fruenger/weather_station/code/weather_station_r4_wifi/README.md

# Weather Station — Arduino UNO R4 WiFi

Standard setup of the station: **one board** reads all sensors and uploads directly to the OST Django API over WiFi. It replaces the former two-board nRF24 setup (archived in `../../legacy/nrf24/`); no receiver Arduino and no `receive.py` on a PC.

## Architecture

```
[Sensors + PCA9548] ──I2C/GPIO──► [UNO R4 WiFi] ──HTTPS──► [Django API / Website]
```

Compared to the former nRF24 setup (`legacy/nrf24/`):

| nRF24 setup | R4 WiFi |
|---|---|
| Sender Arduino + nRF24 | **not needed** |
| Receiver Arduino + nRF24 | **not needed** |
| PC running `receive.py` | **not needed** |
| USB cable for data path | **not needed** |

## Hardware

### Board

- **Arduino UNO R4 WiFi** (not the UNO R4 Minima — Minima has no WiFi)
- Power: 6–24 V on `VIN` (solar/battery) or USB for bench testing
- **2.4 GHz WiFi** only (no 5 GHz)

### Sensors (unchanged)

Same sensors and channel assignment as the former nRF24 sender; pin mapping is identical to `legacy/nrf24/weather_station/weather_station.ino`. The multiplexer is an Adafruit PCA9548 STEMMA QT board (TCA9548A compatible, same address 0x70, no firmware change) on the header I2C bus with V+ = 5 V and its Vlogic switch on 3.3 V, so it also supplies the I2C sensors with 3.3 V. Exception: the PMSA003I takes VIN from the 5 V rail (its fan current would overheat the multiplexer's 3.3 V regulator); only GND/SDA/SCL come from port 0, never connect the red STEMMA QT wire. Do not use the R4's Qwiic port for it: that is a separate 3.3 V-only bus (`Wire1`).

| Pin | Function |
|-----|---|
| A4 (SDA), A5 (SCL) | I2C → PCA9548 (header bus `Wire`, 5 V logic) |
| D2 | Rain reed (tipping bucket) |
| D3 | Anemometer reed contact (interrupt), external RC debounce: R1 10 kΩ to 5 V, C1 100 nF to GND, R2 1 kΩ to the contact |
| D4 | → RESET pin: periodic self-reset, off by default since v1.9.1 (`AUTO_RESET_ENABLED`); input during operation, output LOW to reset |
| D5 | Rain drop digital |
| D6 | PMSA003I SET (sleep/wake) |
| A1 | Rain drop analog |

**Removed:** D8–D12 (formerly nRF24L01 SPI) — no wiring needed.

See `../../wiring/pin_connections_r4_wifi.txt` for the full pin table.

### Power notes (solar / battery)

- R4 WiFi draws more current than a Nano, especially during WiFi transmit.
- Keep **PMSA003I sleep/wake** (already in firmware).
- **WiFi stays connected** (since v1.8). Switching it off between uploads and re-joining every minute was the main cause of hangs in v1.7; the idle connection costs a few tens of mA more.
- Use a solid 5 V regulator and local capacitors on the board and sensors.
- `SERIAL_DEBUG` must be `0` in the field (no USB Serial reader).

## Upload strategy (v1.9 — cooperative scheduler, bulk upload)

| Setting | Value | Meaning |
|---|---|---|
| Snapshot | **1 Hz** (1 s) | Ring buffer + wind pulse window |
| BME280 | **1 Hz** | Temperature, humidity, pressure |
| TSL2591 | **1 Hz** | Lux, non-blocking poll with auto-ranging (see below) |
| MLX90614 | **0.5 Hz** | Sky / box IR temperature |
| UV | **1 Hz** | UV index |
| Rain | **2 Hz** | Reed tips + drop sensor |
| PM | **5 min** | Sleep/wake cycle (unchanged) |
| Ring buffer | **180 samples** | 3 min at 1 Hz |
| Startup live | **5 min @ 1 Hz** | One request per sample, for commissioning |
| Burst | **every 60 s** | Bulk request(s) of ≤ 120 samples (CSV), one TLS session, max 45 s |
| Watchdog | **120 s** | Reset if the main loop stops checking in |
| Upload stall reset | **10 min** | Reset if nothing could be uploaded for 10 min |

### Bulk upload and I2C recovery (v1.9)

v1.8 still stopped uploading about 30 s after the end of the startup live mode. The cause was the I2C bus: it got stuck right after the first PMSA003I measurement (multiplexer channel 0 stayed selected while the sensor was put to sleep). Every I2C access then waited 100 ms for its timeout, the sensors returned garbage (BME280 180 °C, UV 65535), and the first invalid sample in the ring buffer blocked all further uploads. v1.9 changes:

- **Bulk upload:** after the live mode all samples of a minute are sent in one request to `<api path>bulk/` (`Content-Type: text/csv`, header line + one row per sample, see `bulk_csv.h` and the website `docs/upload-hmac-v1.md`). The body is formatted twice — once to compute length and SHA-256 for the signature, once to send it in ~512 byte pieces — so it is never held in RAM as a whole. The server skips invalid rows and samples it already stored, so a retry after a lost response creates no duplicates. **The website must support the bulk endpoint before v1.9 is flashed.**
- **1 Hz snapshots:** wind and rain are counted per second; the website's wind conversion (× 0.14 per revolution per second) now matches directly.
- **No head-of-line blocking:** invalid samples are not sent (counted as `discarded` in the debug report); a block the server rejects with HTTP 400 is dropped instead of retried forever.
- **I2C robustness:**
  - All multiplexer channels are switched off after every PMSA003I access, before the sensor is put to sleep.
  - Readings are checked: an implausible BME280 reading marks the sample as not uploadable, MLX90614 failures are sent as 0/0 ("not available"), UV failures as 0.
  - After `SENSOR_FAIL_LIMIT` failures in a row a sensor is re-initialised.
  - If the multiplexer stops answering or several sensors fail at once, the bus is recovered: 9 SCL pulses, a STOP, `Wire.begin()`, then all sensors are re-initialised. The interval between recoveries grows while they do not help.
- **Upload stall reset:** if nothing could be uploaded for 10 min, the board resets (last resort for failures that leave the loop running).

### Reliable uploads (v1.8)

Firmware up to v1.7 hung a few minutes after boot, as soon as it switched from startup live mode to burst mode. v1.8 changes:

- **Fast responses:** the reply is read up to its `Content-Length` and the connection is reused at once. Before, the firmware waited up to 2 s per upload for the server to close a keep-alive connection, so a burst of 120 samples took several minutes.
- **WiFi stays connected**; it is only re-joined after a failure. `WiFi.begin()` waits at most `WIFI_BEGIN_TIMEOUT_MS`, the rest of `WIFI_CONNECT_TIMEOUT_MS` is polled by the sketch.
- **NTP only every 20 min** (`NTP_RESYNC_INTERVAL_MS`), no longer up to three times per burst.
- **Failed bursts are retried once per `UPLOAD_BURST_INTERVAL_MS`**, not on every snapshot (which blocked the loop with back-to-back connection attempts). Live mode pauses `LIVE_RETRY_DELAY_MS` after a failure.
- **Measuring continues during a burst** (2 Hz snapshots are appended to the ring buffer between uploads); a burst returns to the main loop after `BURST_MAX_DURATION_MS` at the latest.
- **Software watchdog:** a 50 Hz timer interrupt resets the board when the main loop has not checked in for `WATCHDOG_TIMEOUT_MS` (120 s), e.g. inside a hanging library call. The RA4M1 hardware watchdog cannot be used: its maximum of ~5.6 s is shorter than single WiFi modem commands (up to 10 s).
- **Timestamps with millisecond resolution** (`jd` with 7 decimals, ~9 ms). Before, `jd` had 5 decimals (0.86 s) and whole seconds, so samples taken 0.5 s apart could share a timestamp.

### Slower sensors between snapshots

Values for sensors polled less often than the snapshot interval are **held** (last known reading), not averaged. Example: MLX90614 updates every 2 s; the snapshot in between repeats the previous sky/box temperature. This keeps each buffer row self-contained without inventing synthetic averages.

### Light sensor (TSL2591, since v1.6; lux formula since v1.7)

The driver (`TSL2591.cpp`, logic in `tsl2591_logic.h`) integrates continuously and is polled without blocking: `TSL2591_Poll()` returns immediately when no integration has finished, so the 2 Hz snapshot and rain polling are not delayed (the old driver blocked for ≥ 300 ms per read).

- **Auto-ranging in both directions** over eight gain × integration-time stages, from 1×/100 ms (direct sun) to 9876×/600 ms (night sky). A channel at ≥ 90 % of full scale steps one stage down, a reading that would stay below 50 % of full scale on the next stage steps one up. Readings in a saturated state are discarded, except on the least sensitive stage, where they are reported as a lower bound.
- **Lux as float** with the formula of the Adafruit TSL2591 library (since v1.7): `(ch0 − ch1)·(1 − ch1/ch0) / (t·gain / 408)`, capped at 200 000 lx. Unlike the Waveshare formula `(ch0 − 2·ch1) / (t·gain / 762)` used up to v1.6, it stays positive for infrared-rich light (street lighting, light-polluted night sky), so the night sky brightness is measured instead of reading 0 (older drivers wrapped those cases to values such as 53 000 lx).
- **Scale change in v1.7:** values are not comparable with earlier firmware. Daylight (infrared fraction `ch1/ch0` ≈ 0.15–0.3) reads about 40 % lower than with v1.6; at `ch1/ch0` ≥ 0.5 v1.6 reported 0. When flashing v1.7, add a **Calibration epoch** in the website admin so the cloud detection recalibrates.
- In direct sun even the least sensitive stage (1×/100 ms) can saturate. Only `ch0` clips, so the reported value is a lower bound well below the true illuminance; it still marks the interval as very bright.
- **I2C errors** (no ACK, short read) keep the last valid value; after 60 consecutive errors the sensor is re-initialised. `TSL2591_Init()` checks the chip ID, so a missing sensor is reported as unavailable.
- The upload sends `illuminance` with three decimals to resolve the night sky brightness.

Host test of the logic: `cd tools && g++ -std=c++17 -Wall -Wextra -o tsl2591_selftest tsl2591_selftest.cpp && ./tsl2591_selftest`

### Wind

Firmware uploads **raw revolutions per second** (1 Hz snapshots, since v1.9). Rolling means and gust detection belong on the server — see `TODO.md`.

**Buffer sizing:** `RING_BUFFER_SIZE` must be ≥ `UPLOAD_BURST_INTERVAL_MS / SNAPSHOT_INTERVAL_MS` + spare. At 60 s / 1 s → 60 samples; buffer = 180 (one missed burst plus margin).

## Software setup

### 1. Arduino IDE

1. Install board package: **Arduino UNO R4 Boards** (Boards Manager).
2. Select board: **Arduino UNO R4 WiFi**.
3. **Tools → Firmware Updater** — update the WiFi module firmware once (required for HTTPS).

### 2. Libraries

Same as the former nRF24 sender:

- Adafruit BME280, MLX90614, PM25 AQI, BusIO, Unified Sensor
- DFRobot UVIndex240370Sensor + DFRobot RTU
- TSL2591 support files are included in this folder (`DEV_Config.*`, `TSL2591.*`)

No RF24 library needed.

### 3. Credentials (WEATHER-HMAC-V1)

```bash
cd weather_station/code/weather_station_r4_wifi
cp secrets.h.example secrets.h
# Edit secrets.h — WiFi + device_id / key_id / HMAC secret
```

Provision the device on the Django server (from the website project):

```bash
python manage.py provision_upload_device --device-id <your-device-id> --key-id key1
```

Copy the printed `device_id`, `key_id`, and 64-char hex `secret` into `secrets.h` as `SECRET_DEVICE_ID`, `SECRET_KEY_ID`, and `SECRET_HMAC_SECRET_HEX`.

| Define | Purpose |
|---|---|
| `SECRET_WIFI_SSID` / `SECRET_WIFI_PASS` | Observatory 2.4 GHz WiFi |
| `SECRET_API_HOST` / `SECRET_API_PATH` | HTTPS POST target |
| `SECRET_HMAC_PATH` | Canonical signing path (default: `/weather_station/weather_api/datasets/`) |
| `SECRET_DEVICE_ID` | Provisioned device id |
| `SECRET_KEY_ID` | Active signing key id |
| `SECRET_HMAC_SECRET_HEX` | 32-byte secret as 64 hex chars |

**Never log or commit** `SECRET_HMAC_SECRET_HEX` or signatures in the field. Use `SERIAL_DEBUG` only on the bench.

`SECRET_HMAC_PATH` is used only for the canonical string. `SECRET_API_PATH` may differ for local testing, but production should keep both equal.

### 4. Upload sketch

Open `weather_station_r4_wifi.ino` in the Arduino IDE and upload.

For first tests, set `#define SERIAL_DEBUG 1` in the sketch, open Serial Monitor at **115200 baud** (`SERIAL_BAUD`), and verify:

- All sensors initialize
- `weatherHmacSelfTest OK` (known test vectors)
- `NTP time synced` before any upload
- `Upload mode: startup live (1 Hz)` then uploads each second
- After 5 min: `Upload mode: burst (buffered)` and `Burst upload: N samples`

At boot (debug only) an **I2C scan** lists the devices on the main bus and on every multiplexer channel, and marks missing expected sensors:

```
I2C scan
  main bus: 0x70 (multiplexer)
  channel 0: -   <-- expected 0x12 (PMSA003I), answers only while awake
  channel 1: 0x76 (BME280)
  channel 2: 0x23 (SEN0636)
  channel 3: 0x5A (MLX90614)
  channel 4: -   <-- expected 0x29 (TSL2591)
  channel 5: -
  ...
```

Nothing on a channel means no power or no I2C connection on that port (check wire order: black GND, red 3.3 V, blue SDA, yellow SCL); a device at an unexpected address points to a different module or address jumper. Sensors not found at boot are searched again every `SENSOR_RETRY_INTERVAL_MS` (60 s), so a sensor plugged in or repaired later is picked up without a reset.

Every `DEBUG_INTERVAL_MS` (2 s) a sensor report shows the current reading of each sensor (`not available` if it was not found at boot):

```
--- t=125 s [live]  buffer 0/130  pkt 118  uploads ok/failed 118/0
BME280    T 21.34 C   RH 45.2 %   p 1013.2 hPa
MLX90614  sky 18.20 C   box 22.10 C   sky-box -3.90 K   sky-air -3.14 K
TSL2591   1234.567 lx   ch0 2861  ch1 512   stage 3 (25x 400 ms)
SEN0636   UV index 1   raw 412
PMSA003I  PM1.0 3  PM2.5 5  PM10 6 ug/m3   asleep, next in 212 s
Rain      tips 2 since boot   D2 HIGH   drop sensor dry (D5 HIGH, A1 1015)
Wind      pulses 6 per s   6.0 /s (last 2.0 s)   total 412   D3 HIGH
```

Hardware checks with the report:

- **TSL2591:** cover the sensor and shine a lamp on it; the stage should step up in the dark and down in bright light, `ch0` should stay below ~90 % of full scale (36863 at 100 ms, 65535 otherwise) except in direct sun on stage 0.
- **SEN0636:** `raw` resolves much finer than the integer UV index, useful to compare windows (plexiglass vs. quartz).
- **Rain gauge:** tip the bucket slowly by hand and count; `tips` should increase by exactly one per tip. The firmware counts every change of D2, so a reed that only closes briefly while the bucket passes would count two per tip.
- **Anemometer:** turn the cups slowly by hand, one revolution at a time; the pulse total should increase by the number of contact closures per revolution, not by more (otherwise check the RC debounce on D3).
- **Rain drop sensor:** a wet finger on the plate switches it to `wet` and lowers `A1`.

For deployment, set `SERIAL_DEBUG 0` and re-flash.

## API upload format

The sketch POSTs `application/x-www-form-urlencoded` data to:

`https://<SECRET_API_HOST><SECRET_API_PATH>`

### WEATHER-HMAC-V1 authentication

Each POST is signed over the **exact raw body bytes** sent on the wire. Headers:

| Header | Value |
|---|---|
| `X-Weather-Device` | `SECRET_DEVICE_ID` |
| `X-Weather-Key-Id` | `SECRET_KEY_ID` |
| `X-Weather-Timestamp` | Unix UTC seconds (requires NTP) |
| `X-Weather-Nonce` | 32 lowercase hex chars (16 random bytes from hardware TRNG) |
| `X-Weather-Signature` | lowercase hex HMAC-SHA256 |

Canonical string (UTF-8, no trailing newline), lines joined by `\n`:

```
WEATHER-HMAC-V1
POST
<SECRET_HMAC_PATH>
application/x-www-form-urlencoded
<device_id>
<key_id>
<timestamp>
<nonce>
<sha256_hex_of_exact_raw_body>
```

Signing uses vendored **SHA-256 / HMAC-SHA256** (`sha256.c`, based on Brad Conte's public-domain crypto-algorithms). Nonces come from the Renesas **SCE hardware TRNG** (`HW_SCE_RNG_Read`, same path as the ArduinoCore `WMath` TRNG). No mbedtls Library Manager package and no `random()` fallback — if TRNG or signing fails, the upload is skipped and samples stay buffered.

NTP is refreshed about every **20 minutes**. Uploads require `timeSynced`.

On HTTP **401**, **403**, or **429**, buffered samples are **not** dropped. The firmware parses `Retry-After` when present and applies exponential backoff (60 s initial, up to 30 min).

### Payload fields

`jd`, `temperature` (°C), `pressure` (hPa), `humidity` (%), `illuminance` (lux), `wind_speed` (revolutions per sample), `rain` (mm collector depth), `sky_temp`, `box_temp`, `is_raining`, `pm1_0`, `pm2_5`, `pm10`, `uv_index`

Unit conversions applied in firmware:

- **Rain:** tipping-bucket count × 1.25 → mm collector depth (same as the former `receive.py`)
- **Wind:** raw anemometer revolutions per 1 s snapshot, capped at 500 (server converts × 0.14 → m/s)

## Configuration (in .ino)

| Constant | Default | Purpose |
|---|---|---|
| `SERIAL_DEBUG` | `0` | USB debug output |
| `SNAPSHOT_INTERVAL_MS` | `1000` | Ring buffer / wind window (1 Hz) |
| `INTERVAL_BME_MS` | `1000` | BME280 poll rate |
| `INTERVAL_LUX_MS` | `1000` | TSL2591 poll rate |
| `INTERVAL_MLX_MS` | `2000` | MLX90614 poll rate |
| `INTERVAL_UV_MS` | `1000` | UV sensor poll rate |
| `INTERVAL_RAIN_MS` | `500` | Rain reed + drop poll rate |
| `LIVE_UPLOAD_INTERVAL_MS` | `1000` | Startup live upload rate (1 Hz) |
| `STARTUP_LIVE_UPLOAD_MS` | `300000` | Live upload period after boot (5 min) |
| `UPLOAD_BURST_INTERVAL_MS` | `60000` | Burst upload interval in field mode |
| `RING_BUFFER_SIZE` | `180` | Max buffered samples (3 min @ 1 Hz) |
| `BULK_MAX_ROWS` | `120` | Samples per bulk request |
| `WIFI_CONNECT_TIMEOUT_MS` | `20000` | WiFi join timeout |
| `WIFI_BEGIN_TIMEOUT_MS` | `4000` | Time `WiFi.begin()` blocks before the sketch polls |
| `BURST_MAX_DURATION_MS` | `45000` | Max duration of one burst |
| `LIVE_RETRY_DELAY_MS` | `10000` | Pause after a failed live upload |
| `WATCHDOG_TIMEOUT_MS` | `120000` | Software watchdog: reset after 2 min without loop progress |
| `UPLOAD_STALL_RESET_MS` | `600000` | Reset after 10 min without a successful upload |
| `AUTO_RESET_ENABLED` | `0` | Periodic self-reset every `RESET_INTERVAL` (1 h) through D4 → RESET |
| `SENSOR_FAIL_LIMIT` | `3` | Implausible readings in a row before a sensor is re-initialised |
| `I2C_RECOVERY_MIN_INTERVAL_MS` | `10000` | Minimum time between I2C bus recoveries (doubles up to 5 min) |
| `NTP_RESYNC_INTERVAL_MS` | `1200000` | Re-sync NTP every 20 min |
| `UPLOAD_BACKOFF_INITIAL_MS` | `60000` | Initial auth/rate-limit backoff |
| `UPLOAD_BACKOFF_MAX_MS` | `1800000` | Max backoff (30 min) |
| `PM_MEASUREMENT_INTERVAL` | `300000` | PMSA003I wake every 5 min |
| `DISABLE_LED_MATRIX` | `1` | Blank onboard 12×8 LED matrix |

## Power saving

- **Burst upload:** snapshot 2 Hz, uploads once per minute (WiFi stays associated since v1.8)
- **Cooperative scheduler:** each sensor at its own rate (≤ 2 Hz); short `delay()` until next timer
- **Non-blocking wind:** permanent interrupt, 1 s pulse windows
- **Startup live:** 5 min persistent WiFi for easy commissioning, then auto switch to burst
- **`DISABLE_LED_MATRIX`**: all onboard LEDs off after boot
- **`SERIAL_DEBUG 0`**: no blocking Serial in the field
- **PMSA003I sleep/wake**: fan/laser off between PM cycles
- **Rain per interval:** tips per 1 s sample window

## Troubleshooting

| Symptom | Check |
|---|---|
| `WiFi module not found` | Firmware updater, board selection (R4 **WiFi**) |
| `SSL connect failed` | WiFi firmware version, host reachable on 443 |
| `WiFi connect failed` | Signal at the station; WiFi is re-joined once per burst interval |
| `Bulk upload failed, HTTP 0` | No response (timeout); retried with the next burst |
| `Bulk upload rejected (HTTP 400)` | Server rejected the request format; the block is dropped — check the website version (bulk endpoint deployed?) |
| `I2C bus recovery` | The multiplexer stopped answering or several sensors failed; sensors are re-initialised |
| `... failed repeatedly, will be re-initialised` | One sensor returned implausible values `SENSOR_FAIL_LIMIT` times |
| `No successful upload for 10 min, resetting` | Upload stall reset; check WiFi, server and the lines before |
| `Burst time limit reached` | Many samples queued (e.g. after an outage); the rest follows |
| `watchdog OFF` in the debug report | No free timer for the software watchdog |
| Station restarts by itself | Software watchdog (loop blocked > 2 min), upload stall reset (10 min), or the periodic reset via D4 if `AUTO_RESET_ENABLED` is 1 |
| `NTP time sync failed` | Internet access from observatory WiFi |
| `Upload skipped: time not synced` | Wait for NTP; uploads buffer until clock is valid |
| `weatherHmacSelfTest failed` | SHA256/HMAC mismatch — re-flash; check `sha256.c` is compiled with the sketch |
| `Upload skipped: HMAC signing failed` | SCE TRNG or secret parse failure; check `SECRET_HMAC_SECRET_HEX` |
| `Upload deferred (backoff)` | Recent 401/403/429; waits per Retry-After / exponential backoff |
| `Upload skipped: validation failed` | Sensor wiring / bogus readings |
| HTTP 401 / 403 | Wrong device id, key id, or secret; re-provision or rotate key |
| HTTP 429 | Rate limited; firmware backs off, buffer retained |
| HTTP 400 | Field out of range — check Serial debug values |

### HTTPS / certificates

The R4 WiFi firmware embeds a CA bundle that works with most public HTTPS sites (including Let's Encrypt). If SSL fails only for your server, update the WiFi firmware or add a custom root CA via `sslClient.setCACert()` (see [Arduino SSL docs](https://docs.arduino.cc/tutorials/uno-r4-wifi/wifi-examples)).

## Migration from the nRF24 setup (done)

Kept for reference; the old sketches and `receive.py` are in `../../legacy/nrf24/`.

1. Move the sensor shield/cabling from the old sender Uno/Nano to the R4 WiFi (same pins).
2. Remove both nRF24 modules.
3. Configure `secrets.h` and flash `weather_station_r4_wifi.ino`.
4. Run in parallel with the old receiver for a few days if desired.
5. Decommission receiver Arduino + `receive.py` when stable.

## HMAC debug / self-test

**Bench only** (`SERIAL_DEBUG 1`):

1. On boot, confirm `weatherHmacSelfTest OK`.
2. Confirm `NTP time synced` before uploads.
3. Log HTTP status lines only — never print `SECRET_HMAC_SECRET_HEX`, nonces, or signatures in production.

**Host-side checks** (Linux, OpenSSL dev headers; run in CI by `.github/workflows/firmware-selftests.yml`):

```bash
cd code/weather_station_r4_wifi/tools
g++ -std=c++17 -Wall -Wextra -o hmac_selftest hmac_selftest.cpp -lcrypto && ./hmac_selftest
gcc -Wall -c ../sha256.c -o sha256.o
g++ -std=c++17 -Wall -Wextra -o bulk_csv_selftest bulk_csv_selftest.cpp sha256.o && ./bulk_csv_selftest
g++ -std=c++17 -Wall -Wextra -o tsl2591_selftest tsl2591_selftest.cpp && ./tsl2591_selftest
```

The binaries are gitignored.

Expected vectors are in `tools/hmac_test_vectors.txt`. Firmware `weatherHmacSelfTest()` uses the same constants.

## File layout

```
weather_station_r4_wifi/
├── weather_station_r4_wifi.ino   # Main sketch
├── weather_hmac.h / .cpp         # WEATHER-HMAC-V1 helpers
├── bulk_csv.h                    # CSV line format of the bulk upload (host-testable)
├── sha256.h / .c                 # Vendored SHA-256 + HMAC (no mbedtls)
├── secrets.h.example             # Template credentials
├── secrets.h                     # Your credentials (gitignored, create locally)
├── tools/
│   ├── hmac_test_vectors.txt     # Known WEATHER-HMAC-V1 digests
│   ├── hmac_selftest.cpp         # Host OpenSSL vector check
│   ├── bulk_csv_selftest.cpp     # Host check of bulk CSV + incremental SHA-256
│   └── tsl2591_selftest.cpp      # Host check of lux formula + auto-ranging
├── TODO.md                       # Open items: energy, wind, light sensor
├── DEV_Config.* / TSL2591.*      # Light sensor driver (I2C helpers, polling)
├── tsl2591_logic.h               # Lux formula + auto-ranging (host-testable)
└── README.md                     # This file
```
