fruenger/weather_station/wiring/wiring_r4_wifi.html

# Weather station wiring

Arduino UNO R4 WiFi with Adafruit PCA9548 I²C multiplexer (TCA9548A compatible). Hover a wire, pin or rail label to highlight its connections; click a component for its pin table. Power is drawn as rail labels: every pin labelled 5V, 3V3 or GND is connected to that rail.

### Select a component

Click a box in the diagram.

The panel lists every pin of the selected component and what it is connected to.

Clear selection

## Signal and I²C connections

Net | From | To | Notes

## Power rails

Rail | Pins | Notes

## Notes

- Power is drawn as net labels: all pins labelled 5V, 3V3 or GND are connected to that rail.
- PCA9548 on the header I²C bus (A4/A5, 5 V logic) with V+ = 5 V; not on the Qwiic port (separate 3.3 V bus Wire1).
- Vlogic switch on 3.3 V: the ports supply the I²C sensors with 3.3 V power and logic (on-board regulator, max 500 mA).
- PMSA003I: VIN from the 5 V rail (fan current would overheat the 3.3 V regulator); do not connect the red STEMMA QT wire.
- Anemometer (reed contact, 2 wires): RC debounce with R1 10 kΩ pull-up to 5 V, C1 100 nF to GND, R2 1 kΩ in series with the contact.
- D4 → RESET for the optional periodic self-reset (off by default since firmware 1.9.1). D8–D12 are free.
- Bulk capacitor on the 5 V rail and 100 nF at every module recommended (PMSA003I fan, WiFi bursts).
