fruenger/weather_station/code/weather_station_r4_wifi/DEV_Config.cpp

/*****************************************************************************
* | File      	:   DEV_Config.c
* | Author      :   Waveshare team
* | Function    :   Hardware underlying interface
* | Info        :
*----------------
* |	This version:   V2.0
* | Date        :   2019-07-08
* | Info        :   Basic version
*
******************************************************************************/
#include "DEV_Config.h"

uint8_t DEV_SPI_Device = 0, DEV_I2C_Device = 0;
uint8_t I2C_ADDR;
/******************************************************************************
function:	GPIO Function initialization and transfer
parameter:
Info:
******************************************************************************/
void DEV_GPIO_Mode( UWORD Pin, UWORD mode)
{
    /*
        0:  INPT   
        1:  OUTP
    */
	if(mode == INPUT || mode == 0){
        pinMode(Pin, INPUT);
	}else if(mode == OUTPUT || mode == 1){
		pinMode(Pin, OUTPUT);
	}
}


/**
 * delay x ms
**/
void DEV_Delay_ms(UDOUBLE xms)
{
	delay(xms);
}


void GPIO_Config(void)
{
    //DEV_GPIO_Mode(INT_PIN, 0);
}

/******************************************************************************
function:	SPI Function initialization and transfer
parameter:
Info:
******************************************************************************/
void DEV_SPI_Init()
{
#if DEV_SPI  
	DEV_SPI_Device = 1;
#endif
}

void DEV_SPI_WriteByte(uint8_t Value)
{
#if DEV_SPI  
	
#endif
}

void DEV_SPI_Write_nByte(uint8_t *pData, uint32_t Len)
{
#if DEV_SPI  
	
#endif
}
/******************************************************************************
function:	I2C Function initialization and transfer
parameter:
Info:
******************************************************************************/
// Wire.begin() is called once by the sketch (initializeI2CMultiplexer)
void DEV_I2C_Init(uint8_t Add)
{
#if DEV_I2C 
    DEV_I2C_Device = 1;
    I2C_ADDR =  Add;
#endif
}

void I2C_Write_Byte(uint8_t Cmd, uint8_t value)
{
#if DEV_I2C 
    Wire.beginTransmission(I2C_ADDR);
    Wire.write(Cmd);
    Wire.write(value & 0xFF);
    Wire.endTransmission();
#endif
}

// Returns the byte, or -1 if the device did not answer
int I2C_Read_Byte(uint8_t Cmd)
{
#if DEV_I2C 
    Wire.beginTransmission(I2C_ADDR);
    Wire.write(Cmd);
    if (Wire.endTransmission() != 0) {
        return -1;
    }
    if (Wire.requestFrom(I2C_ADDR, (size_t)1) != 1 || !Wire.available()) {
        return -1;
    }
    return Wire.read();
#endif
}

// Returns the little-endian word (0..65535), or -1 if the device did not answer
int I2C_Read_Word(uint8_t Cmd)
{
#if DEV_I2C 
    uint16_t x; uint16_t t;

    Wire.beginTransmission(I2C_ADDR);
    Wire.write(Cmd); 
    if (Wire.endTransmission() != 0) {
        return -1;
    }
    if (Wire.requestFrom(I2C_ADDR, (size_t)2) != 2 || Wire.available() < 2) {
        return -1;
    }
    t = Wire.read();
    x = Wire.read();
    x <<= 8;
    x |= t;
    return x;
#endif
}
/******************************************************************************
function:	Module Initialize, the library and initialize the pins, SPI protocol
parameter:
Info:
******************************************************************************/
UBYTE DEV_ModuleInit(void)
{
    GPIO_Config();
    DEV_I2C_Init(0x29);
    return 0;
}

/******************************************************************************
function:	Module exits, closes SPI and BCM2835 library
parameter:
Info:
******************************************************************************/
void DEV_ModuleExit(void)
{
	
}
