fruenger/weather_station/code/receive/receive.py

#!/usr/bin/python
"""
Weather Station Data Receiver and Uploader

This script receives weather station data from an Arduino via serial communication
and uploads it to a remote server. It features robust error handling, data validation,
and asynchronous processing to ensure reliable data transmission.

Features:
- Asynchronous data reading and server uploading using threading
- Data validation for sensor value ranges
- Local CSV storage for failed uploads
- Retry mechanism for network failures
- Non-blocking serial communication
- Configuration file support for credentials

Data Format:
The Arduino sends 16 int16_t values in binary format (32 bytes - nRF24L01 limit):
[timestamp, temperature*100, pressure/10, humidity*100, illuminance, rain_tips, wind_revolutions, packet_number, sky_temp*100, box_temp*100, rain_detection, rain_analog, pm1_0, pm2_5, pm10, uv_index]

Author: Weather Station Project
Version: 2.2 (Updated for DFRobot SEN0636 UV Index Sensor)
Date: 2025-07-16
"""

from serial import Serial
from serial.tools import list_ports
import time
import numpy as np
from datetime import datetime, date, timezone
import struct
import requests
import threading
import queue
from astropy.time import Time
from config import get_server_credentials, get_arduino_port_search, get_data_config
from hmac_upload import encode_form, parse_secret_hex, sign_request

import os
import platform


def clear_windows_port(port_device):
    """Clear Windows COM port to resolve access issues.
    
    Args:
        port_device (str): COM port device (e.g., 'COM12')
    """
    if platform.system() == 'Windows':
        try:
            # Try to open and immediately close the port to clear any stale handles
            temp_serial = Serial(port_device, baudrate=115200, timeout=0.1)
            temp_serial.close()
            time.sleep(1.0)  # Give Windows more time to release the port
            print(f"[INFO] Cleared port {port_device}")
        except Exception as e:
            print(f"[WARNING] Could not clear port {port_device}: {e}")


def reset_arduino_connection(port_device):
    """Try to reset Arduino connection by cycling the port.
    
    Args:
        port_device (str): COM port device (e.g., 'COM12')
    """
    if platform.system() == 'Windows':
        try:
            print(f"[INFO] Attempting to reset Arduino connection on {port_device}")
            
            # Try to open port with DTR control
            temp_serial = Serial(port_device, baudrate=115200, timeout=0.1)
            
            # Toggle DTR to reset Arduino (if supported)
            temp_serial.setDTR(False)
            time.sleep(0.1)
            temp_serial.setDTR(True)
            time.sleep(0.1)
            
            temp_serial.close()
            time.sleep(2.0)  # Give Arduino time to reset
            print(f"[INFO] Reset Arduino connection on {port_device}")
            
        except Exception as e:
            print(f"[WARNING] Could not reset Arduino connection: {e}")


def wait_for_arduino_data(serial, timeout=15):
    """Wait for Arduino to start sending data.
    
    Args:
        serial: Serial connection object
        timeout (int): Maximum time to wait in seconds
        
    Returns:
        bool: True if data is available, False if timeout
    """
    start_time = time.time()
    while (time.time() - start_time) < timeout:
        if serial.in_waiting > 0:
            print(f"[INFO] Data available ({serial.in_waiting} bytes)")
            return True
        time.sleep(0.5)
    
    print(f"[WARNING] No data available after {timeout} seconds")
    return False


def try_read_data_directly(serial, timeout=5):
    """Try to read data directly without waiting for markers.
    
    Args:
        serial: Serial connection object
        timeout (int): Maximum time to wait in seconds
        
    Returns:
        bytes: Data bytes if successful, None if failed
    """
    try:
        # Wait for enough data to be available
        start_time = time.time()
        while (time.time() - start_time) < timeout:
            if serial.in_waiting >= 32:
                break
            time.sleep(0.1)
        
        if serial.in_waiting < 32:
            print(f"[WARNING] Not enough data available: {serial.in_waiting} bytes")
            return None
        
        # Read exactly 32 bytes
        data_bytes = serial.read(32)
        print(f"[DEBUG] Read {len(data_bytes)} bytes: {data_bytes.hex()}")
        
        if len(data_bytes) == 32:
            return data_bytes
        else:
            print(f"[WARNING] Incomplete read: {len(data_bytes)} bytes")
            return None
            
    except Exception as e:
        print(f"[ERROR] Error reading data directly: {e}")
        return None


def find_port(port_name):
    """Find the correct COM port that matches the description.
    
    Args:
        port_name (str): The desired COM port's name.
    
    Returns:
        Com port object or None if not found.
    """
    all_comports = list_ports.comports()
    all_port_descriptions = [portinfo.description for portinfo in all_comports]
    
    for i, description in enumerate(all_port_descriptions):
        if description.find(port_name) > -1:
            comport = all_comports[i]
            return comport
    
    return None


def check_arduino_ide_running():
    """Check if Arduino IDE Serial Monitor might be running.
    
    Returns:
        bool: True if Arduino IDE processes are detected
    """
    if platform.system() == 'Windows':
        try:
            import subprocess
            
            # Check for Arduino IDE processes
            result = subprocess.run(['tasklist', '/FI', 'IMAGENAME eq java.exe'], 
                                  capture_output=True, text=True, timeout=5)
            
            if result.returncode == 0 and 'java.exe' in result.stdout:
                print("[WARNING] Java process detected - Arduino IDE might be running")
                print("[INFO] Please close Arduino IDE Serial Monitor and try again")
                return True
                
        except Exception as e:
            print(f"[WARNING] Could not check for Arduino IDE: {e}")
    
    return False


def reset_arduino_driver_windows(port_device):
    """Try to reset Arduino driver under Windows using devcon.
    
    Args:
        port_device (str): COM port device (e.g., 'COM12')
    """
    if platform.system() == 'Windows':
        try:
            # Try to disable and re-enable the USB device
            import subprocess
            
            # Find the device ID for the Arduino
            result = subprocess.run(['wmic', 'path', 'win32_pnpentity', 'where', 
                                   f'Caption like "%{port_device}%"', 'get', 'DeviceID'], 
                                  capture_output=True, text=True, timeout=10)
            
            if result.returncode == 0 and result.stdout.strip():
                device_id = result.stdout.strip().split('\n')[1].strip()
                print(f"[INFO] Found device ID: {device_id}")
                
                # Try to disable and re-enable the device
                subprocess.run(['pnputil', '/disable-device', device_id], 
                             capture_output=True, timeout=10)
                time.sleep(2)
                subprocess.run(['pnputil', '/enable-device', device_id], 
                             capture_output=True, timeout=10)
                time.sleep(3)
                print(f"[INFO] Reset device {device_id}")
                
        except Exception as e:
            print(f"[WARNING] Could not reset Arduino driver: {e}")


def validate_sensor_data(data):
    """
    Validate sensor data for reasonable ranges.
    
    Args:
        data (tuple): Tuple of 16 int16_t values from sensors
        
    Returns:
        bool: True if data is valid, False otherwise
    """
    if len(data) != 16:
        return False
    
    # Extract the main sensor data (first 15 values including PMSA003I)
    timestamp, temp_scaled, pressure_scaled, humidity_scaled, illuminance, rain_tips, wind_revolutions, packet_number, sky_temp_scaled, box_temp_scaled, rain_detection, rain_analog, pm1_0, pm2_5, pm10, uv_index = data
    
    # Convert scaled values back to physical units for validation
    temperature = temp_scaled / 100.0  # Convert back from scaled integer
    pressure = pressure_scaled / 10.0  # Convert back from scaled integer
    humidity = humidity_scaled / 100.0  # Convert back from scaled integer
    sky_temp = sky_temp_scaled / 100.0  # Convert back from scaled integer
    box_temp = box_temp_scaled / 100.0  # Convert back from scaled integer
    
    # Check for reasonable ranges
    if not (-32700 <= temp_scaled <= 8000):  # Temperature range (-327°C to +80°C scaled)
        print(f"[WARNING] Temperature out of range: {temperature}°C (scaled: {temp_scaled})")
        return False
    
    if not (8000 <= pressure_scaled <= 12000):  # Pressure range (800-1200 hPa scaled)
        print(f"[WARNING] Pressure out of range: {pressure} hPa (scaled: {pressure_scaled})")
        return False
    
    if not (0 <= humidity_scaled <= 10000):  # Humidity range (0-100% scaled)
        print(f"[WARNING] Humidity out of range: {humidity}% (scaled: {humidity_scaled})")
        return False
    
    if not (0 <= illuminance <= 65535):  # Light range (scaled lux, max 655.35 actual lux)
        print(f"[WARNING] Illuminance out of range: {illuminance} (scaled), {illuminance * 100.0} lux (actual)")
        return False
    
    if not (0 <= rain_tips <= 65535):  # Rain tips range
        print(f"[WARNING] Rain tips out of range: {rain_tips}")
        return False
    
    if not (0 <= wind_revolutions <= 65535):  # Wind revolutions range
        print(f"[WARNING] Wind revolutions out of range: {wind_revolutions}")
        return False
    
    # MLX90614 validation
    if not (-32700 <= sky_temp_scaled <= 8000):  # Sky temperature range (-327°C to +80°C scaled)
        print(f"[WARNING] Sky temperature out of range: {sky_temp}°C (scaled: {sky_temp_scaled})")
        return False
    
    if not (-32700 <= box_temp_scaled <= 8000):  # Box temperature range (-327°C to +80°C scaled)
        print(f"[WARNING] Box temperature out of range: {box_temp}°C (scaled: {box_temp_scaled})")
        return False
    
    # Rain drop sensor validation
    if not (0 <= rain_detection <= 1):  # Binary rain detection (0 or 1)
        print(f"[WARNING] Rain detection out of range: {rain_detection}")
        return False
    
    if not (0 <= rain_analog <= 1023):  # Analog rain sensor value (0-1023)
        print(f"[WARNING] Rain analog value out of range: {rain_analog}")
        return False
    
    # PMSA003I particulate matter sensor validation (ug/m3)
    if not (0 <= pm1_0 <= 1000):
        print(f"[WARNING] PM1.0 out of range: {pm1_0} ug/m3")
        return False

    if not (0 <= pm2_5 <= 1000):
        print(f"[WARNING] PM2.5 out of range: {pm2_5} ug/m3")
        return False

    if not (0 <= pm10 <= 1000):
        print(f"[WARNING] PM10 out of range: {pm10} ug/m3")
        return False

    if not (0 <= uv_index <= 20):
        print(f"[WARNING] UV index out of range: {uv_index}")
        return False
    
    return True


def convert_scaled_data_to_physical(data):
    """
    Convert scaled integer data back to physical units.
    
    Args:
        data (tuple): Tuple of 16 int16_t values from Arduino
        
    Returns:
        dict: Dictionary with physical units and calculated values
    """
    # Extract main sensor data (first 15 values including PMSA003I)
    timestamp, temp_scaled, pressure_scaled, humidity_scaled, illuminance, rain_tips, wind_revolutions, packet_number, sky_temp_scaled, box_temp_scaled, rain_detection, rain_analog, pm1_0, pm2_5, pm10, uv_index = data
    
    # Convert scaled values back to physical units
    temperature = temp_scaled / 100.0  # Convert back from scaled integer
    pressure = pressure_scaled / 10.0  # Convert back from scaled integer (hPa)
    humidity = humidity_scaled / 100.0  # Convert back from scaled integer
    sky_temp = sky_temp_scaled / 100.0  # Convert back from scaled integer
    box_temp = box_temp_scaled / 100.0  # Convert back from scaled integer
    
    # Convert illuminance from scaled value (divided by 100 in Arduino) back to actual lux
    illuminance_actual = illuminance * 100.0  # Convert back to actual lux
    
    # Rain (collector depth in mm for this packet):
    #   - Each tip adds 1.25 mm depth in the 130 mm (r = 65 mm) collector.
    #   - Uploaded as field `rain` = rain_tips * 1.25 (mm in collector).
    #   - The website converts collector mm → mm/m² with factor 10000/132730 ≈ 0.07534.
    rain_mm = rain_tips * 1.25
    wind_speed = float(wind_revolutions)  # Anemometer revolutions per sample (website × 0.14 → m/s)
    # pressure is already in hPa from scaled integer; no further conversion here
    
    # Convert rain detection to boolean
    is_raining = bool(rain_detection)
    
    return {
        'timestamp': timestamp,
        'temperature': temperature,
        'pressure': pressure,
        'humidity': humidity,
        'illuminance': illuminance_actual,  # Use corrected lux value
        'rain_tips': rain_tips,
        'rain_mm': rain_mm,
        'wind_revolutions': wind_revolutions,
        'wind_speed': wind_speed,
        'packet_number': packet_number,
        'sky_temp': sky_temp,
        'box_temp': box_temp,
        'is_raining': is_raining,
        'rain_analog': rain_analog,
        'pm1_0': pm1_0,
        'pm2_5': pm2_5,
        'pm10': pm10,
        'uv_index': uv_index
    }


def upload_data_to_server(data, device_id, key_id, secret_hex, server_url, canonical_path):
    """Upload weather data using WEATHER-HMAC-V1 (exact body bytes signed)."""
    try:
        jd = Time(datetime.now(timezone.utc)).jd
        upload_data = {
            'jd': jd,
            'temperature': data['temperature'],
            'pressure': data['pressure'],
            'humidity': data['humidity'],
            'illuminance': data['illuminance'],
            'wind_speed': data['wind_speed'],
            'rain': data['rain_mm'],
            'sky_temp': data['sky_temp'],
            'box_temp': data['box_temp'],
            'is_raining': 1 if data['is_raining'] else 0,
            'rain_analog': data['rain_analog'],
            'pm1_0': data['pm1_0'],
            'pm2_5': data['pm2_5'],
            'pm10': data['pm10'],
            'uv_index': data['uv_index'],
        }

        body = encode_form(upload_data)
        secret = parse_secret_hex(secret_hex)
        body, headers = sign_request(
            secret,
            device_id=device_id,
            key_id=key_id,
            body=body,
            canonical_path=canonical_path,
        )
        response = requests.post(
            server_url,
            data=body,
            headers=headers,
            timeout=10,
        )

        if response.status_code in [200, 201]:
            print(
                f"[SUCCESS] Data uploaded successfully "
                f"(Packet {data['packet_number']}) - Status: {response.status_code}"
            )
            return True

        body_text = (response.text or '').strip().replace('\n', ' ')
        if len(body_text) > 500:
            body_text = body_text[:500] + '…'
        print(
            f"[ERROR] Server returned status {response.status_code} "
            f"for {server_url}: {body_text or '(empty response)'}"
        )
        return False

    except requests.exceptions.RequestException as e:
        print(f"[ERROR] Network error during upload: {e}")
        return False
    except Exception as e:
        print(f"[ERROR] Unexpected error during upload: {e}")
        return False


def save_failed_data(data, filename):
    """Save failed upload data to local CSV file.

    Args:
        data (dict): Weather data to save
        filename (str): CSV filename
    """
    try:
        timestamp = datetime.now().strftime("%Y-%m-%d %H:%M:%S")

        # Create CSV line
        csv_line = f"{timestamp},{data['temperature']},{data['pressure']},{data['humidity']},{data['illuminance']},{data['wind_speed']},{data['rain_mm']},{data['sky_temp']},{data['box_temp']},{1 if data['is_raining'] else 0},{data['rain_analog']},{data['pm1_0']},{data['pm2_5']},{data['pm10']},{data['uv_index']}\n"

        # Append to file
        with open(filename, 'a') as f:
            f.write(csv_line)

        print(f"[INFO] Failed data saved to {filename}")
        
    except Exception as e:
        print(f"[ERROR] Failed to save data to CSV: {e}")


def upload_worker(data_queue, failed_data_file, device_id, key_id, secret_hex, server_url, canonical_path):
    """Worker thread for uploading data to server with HMAC-v1."""
    while True:
        try:
            data = data_queue.get(timeout=1)
            if not upload_data_to_server(
                data, device_id, key_id, secret_hex, server_url, canonical_path
            ):
                save_failed_data(data, failed_data_file)
        except queue.Empty:
            continue
        except Exception as e:
            print(f"[ERROR] Upload worker error: {e}")
            time.sleep(1)


def readline(port_name, timestamp=True):
    """Read a line of data from serial port with marker detection.
    
    Args:
        port_name (str): The port name to connect to.
        timestamp (bool): Whether to include timestamp
        
    Returns:
        tuple: (timestamp, data) or data depending on timestamp parameter
    """
    comport = find_port(port_name)
    if comport is None:
        raise RuntimeError(f"Port '{port_name}' not found")
    
    with Serial(comport.device) as serial:
        # Wait for start marker 'D'
        start_time = time.time()
        while (time.time() - start_time) < 10:  # 10 second timeout
            marker = serial.read(1)
            if marker == b'D':
                break
            elif marker == b'':  # No data available
                time.sleep(0.1)
                continue
            else:
                # Skip any other characters (like text messages from Arduino)
                continue
        
        if marker != b'D':
            raise RuntimeError("Start marker 'D' not found within timeout")
        
        # Read exactly 32 bytes (16 int16_t values)
        data_bytes = serial.read(size=32)
        if len(data_bytes) != 32:
            raise RuntimeError(f"Incomplete data received: {len(data_bytes)} bytes instead of 32")
        
        # Check for end marker 'E'
        end_marker = serial.read(1)
        if end_marker != b'E':
            print(f"[WARNING] End marker 'E' not found, got: {end_marker}")
        
        # Unpack data as 16 int16_t values
        data = struct.unpack('16h', data_bytes)  # 'h' for int16_t
        
        # Validate data (check for reasonable ranges)
        if not validate_sensor_data(data):
            raise RuntimeError("Sensor data validation failed")
        
        if timestamp:
            return (str(date.today()) + " " + datetime.now().strftime("%H:%M:%S"), data)
        else:
            return data


def main():
    """Main function for weather station data receiver."""
    print("Weather Station Data Receiver")
    print("Version 2.2")
    print("=" * 50)
    
    # Load configuration (HMAC-v1)
    data_config = get_data_config()
    device_id, key_id, secret_hex, server_url, canonical_path = get_server_credentials()

    # Configuration from file
    failed_data_file = data_config.get("failed_data_file", "failed_uploads.csv")
    queue_size = data_config.get("queue_size", 100)
    data_queue = queue.Queue(maxsize=queue_size)

    upload_thread = threading.Thread(
        target=upload_worker,
        args=(
            data_queue,
            failed_data_file,
            device_id,
            key_id,
            secret_hex,
            server_url,
            canonical_path,
        ),
        daemon=True,
    )
    upload_thread.start()
    print("[INFO] Upload worker thread started (HMAC-v1)")
    
    # Find Arduino port using the old working method
    PORT_NAME = "USB-SERIAL CH340"  # The correct port descriptor from the old code
    
    print("[INFO] Looking for Arduino...")
    comport = find_port(PORT_NAME)
    
    if comport is None:
        print(f"[ERROR] Arduino not found! Searched for: {PORT_NAME}")
        print("[INFO] Available COM ports:")
        for port in list_ports.comports():
            print(f"  - {port.device}: {port.description}")
        return
    
    print(f"[INFO] Found Arduino on {comport.device}: {comport.description}")
    
    # Main data processing loop
    consecutive_failures = 0
    max_consecutive_failures = 3
    
    while True:
        try:
            # Read data from serial (this is the only blocking operation)
            data_table = readline(PORT_NAME, timestamp=False)
            print("[INFO] Measurement completed!")
            
            # Reset failure counter on success
            consecutive_failures = 0
            
            # Convert scaled integer data to physical units
            physical_data = convert_scaled_data_to_physical(data_table)
            
            # Extract values for upload
            timestamp = physical_data['timestamp']
            temperature = physical_data['temperature']
            pressure = physical_data['pressure']
            humidity = physical_data['humidity']
            illuminance = physical_data['illuminance']
            wind_speed = physical_data['wind_speed']
            rain = physical_data['rain_mm']
            packet_number = physical_data['packet_number']
            sky_temp = physical_data['sky_temp']
            box_temp = physical_data['box_temp']
            is_raining = physical_data['is_raining']
            rain_analog = physical_data['rain_analog']
            pm1_0 = physical_data['pm1_0']
            pm2_5 = physical_data['pm2_5']
            pm10 = physical_data['pm10']
            uv_index = physical_data['uv_index']
            
            print(f"[DATA] Timestamp: {timestamp}, Temp: {temperature}°C, Pressure: {pressure} hPa, Humidity: {humidity}%, Light: {illuminance} lux, Wind: {wind_speed} rev, Rain: {rain} mm (collector), Sky: {sky_temp}°C, Box: {box_temp}°C, Raining: {'YES' if is_raining else 'NO'}, Analog: {rain_analog}, PM1.0: {pm1_0} PM2.5: {pm2_5} PM10: {pm10} ug/m3, UV Index: {uv_index}, Packet: {packet_number}")
            
            # Prepare data for upload
            jd = Time(datetime.now(timezone.utc)).jd
            data = {
                'jd'          : jd,
                'temperature' : temperature,
                'pressure'    : pressure,  
                'humidity'    : humidity,
                'illuminance' : illuminance,
                'wind_speed'  : wind_speed,
                'rain'        : rain,      # kept for compatibility (not used downstream)
                'rain_mm'     : rain,      # required by upload/save helpers
                'sky_temp'    : sky_temp,
                'box_temp'    : box_temp,
                'is_raining'  : 1 if is_raining else 0,  # Convert boolean to integer for server
                'rain_analog' : rain_analog,
                'pm1_0'       : pm1_0,
                'pm2_5'       : pm2_5,
                'pm10'        : pm10,
                'uv_index'    : uv_index,
                'packet_number': packet_number
            }

            # Add data to upload queue (non-blocking)
            try:
                data_queue.put(data, timeout=1)  # 1 second timeout
                print(f"[INFO] Data queued for upload (queue size: {data_queue.qsize()})")
            except queue.Full:
                print("[WARNING] Upload queue full, saving data locally")
                save_failed_data(data, failed_data_file)
                
        except Exception as e:
            consecutive_failures += 1
            print(f"[ERROR] Critical error in main loop (failure {consecutive_failures}/{max_consecutive_failures}): {e}")
            
            if consecutive_failures >= max_consecutive_failures:
                print(f"[ERROR] Too many consecutive failures ({consecutive_failures}), waiting longer before retry")
                time.sleep(30)  # Wait 30 seconds before retrying
                consecutive_failures = 0  # Reset counter
            else:
                time.sleep(5)  # Short wait before retrying


if __name__ == "__main__":
    main()
