fruenger/weather_station/(commit log)

2024-02-04 Updated weather_station_minimum
    Add a periodic reset sequence to avoid malfunction of the weather station due to long awake times.
    [TSL2591.cpp]
2024-03-12 Adds support for a new quantitative rain sensor
2025-07-16 Initial commit of version 2. Restructres the code, adds support for aditional sensors, and improves error tolerance
    [config.py, receive.ino, receive.py]
2025-07-17 Bug fixes + adds temperature and humidity compensation for CCS811 air quality sensor
    [weather_station.ino]
2025-07-17 Adds test programs for ir and air quality sensor
2025-07-29 Some bug fixes and cleanup
    [air_quality_test.ino, air_quality_with_compensation_test.ino, ir_sensor_test.ino, weather_station.ino]
2025-07-29 CSN pin changed
2025-08-18 Fixes for version 2
    [i2c_pin_test.ino, i2c_scanner_v2.ino, i2c_test.ino, receive.ino, receive.py, test_reed_sensor_II.ino.ino, weather_station.ino, weather_station_test.ino]
2025-08-18 Windows port issue fix
    [receive.py]
2025-08-18 Windows port issue fix 2
    [receive.py]
2025-08-18 Windows port issue fix 3
    [receive.py]
2025-08-18 Windows port issue fix 4
    [receive.py]
2025-08-18 Windows port fix 5
    [receive.py]
2025-08-18 Windows port fix 6
    [receive.py]
2025-08-18 Windows port fix 7
    [receive.py]
2025-08-18 Windows port fix 8
    [receive.py]
2025-08-18 Windows port fix 9
    [receive.py]
2025-08-18 Windows port fix 10
    [receive.py]
2026-01-06 Bug fix in temperature sanity check
    [receive.py]
2026-06-10 Bug fixes and documentation updates
    [config.py, receive.py]
2026-06-11 Adds test for Gravity UV sensor (SKU SEN0636) & Adafruit PMSA003I air quality sensor
2026-06-23 Adds test sketch for Adafruit GUVA-S12SD sensor
2026-06-26 Update README and code to replace CCS811 air quality sensor with PMSA003I particulate matter sensor; version bump to 2.1. Adjust data formats, validation, and initialization routines accordingly.
    [receive.ino, receive.py, weather_station.ino]
2026-06-26 Update README, code, and wiring documentation for DFRobot SEN0636 UV Index sensor integration; version bump to 2.2. Adjust data formats, initialization routines, and add support for UV index readings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
2026-07-07 Update README and code for Arduino UNO R4 WiFi integration; version bump to 2.2.1. Enhance RF24 configuration, add debugging options, and remove obsolete transmit test sketch. Update .gitignore to ex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
2026-07-09 Update README and code for Weather Station R4 WiFi; version bump to 1.4. Introduce cooperative scheduling for sensor data collection, implement burst upload strategy, and enhance power-saving feature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
2026-07-28 Refactor weather station configuration and upload process for HMAC authentication. Update config structure to include device_id, key_id, and HMAC secret. Implement atomic JSON writing and enhance per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
2026-10-06 Fixes some issues with the light sensor
    [DEV_Config.cpp, TSL2591.cpp, TSL2591.h, tsl2591_logic.h, weather_station_r4_wifi.ino]
2026-10-07 Updates wiring
2026-10-09 Updates setup with new I2C multiplexer (Adafruit PCA9548 STEMMA QT)
2026-10-12 Updates wiring regarding anemometer
2026-10-16 Updates wiring of particle sensor & adss additional debug output
